chad416/hydraulic-cylinder-design-verification/reports/LD-80.md

# Calculation report LD-80: Loader-arm double-acting cylinder, pinned both ends, long stroke

Generated by `python -m cylver report`. Every number below is computed from `data/orders/LD-80.json` and `data/materials.json`. Sources and their check status: DOSSIER.md section 13.

## Revision history

| variant | tube OD | rod | buckling | fatigue (gov) | cushion peak bar | not met | open |
|---|---|---|---|---|---|---|---|
| rev A | 90.0 | 50 | 0.96 | 0.35 port A cross-bore | 463 | R-07, R-08, R-10 | R-15 |
| rev B | 90.0 | 63 | 1.65 | 0.39 port A cross-bore | 411 | R-08, R-10, R-11 | R-15 |
| rev C | 90.0 | 63 | 1.65 | 1.10 tube-to-base weld | 273 | none | R-15 |

## Analyses per revision

### rev A

| item | value |
|---|---|
| bore / rod / stroke | 80 / 50 / 1200 mm |
| rated / relief / supply | 200 / 220 / 200 bar |
| tube (sized) | E355+SR, OD 90.0 mm, wall 5.00 mm |
| base (sized) | 15 mm |
| rod | 42CrMo4+QT, Re 650 MPa (ruling section 50 mm) |
| pin-to-pin closed / extended | 1455 / 2655 mm |
| ports | through the tube wall |
| girth weld from base face | 6 mm |
| retract command limit | 1 |
| seals rod / piston | PU_ucup / PU_compact |

**Requirements**

| ID | requirement | method | result | limit | status |
|---|---|---|---|---|---|
| R-01 | The cylinder shall extend at >= 285 mm/s against 60 kN with full valve command. | A (duty simulation); T (bench) | 297 mm/s | >= 285 mm/s | met |
| R-02 | Stress 'tube bore von Mises, relief pressure' shall not exceed 225 MPa (Pm). | A | 182 MPa | <= 225 MPa | met |
| R-03 | Stress 'tube bore von Mises, proof pressure' shall not exceed 450 MPa (proof). | A | 272 MPa | <= 450 MPa | met |
| R-04 | Stress 'base plate centre (simply supported bound), relief' shall not exceed 338 MPa (Pb). | A | 194 MPa | <= 338 MPa | met |
| R-05 | Stress 'tube wall at the base junction, membrane + edge bending, 0 -> relief' shall not exceed 900 MPa (PL+Pb+Q). | A | 371 MPa | <= 900 MPa | met |
| R-06 | Stress 'rod thread at piston, pull at relief (no preload credit)' shall not exceed 325 MPa (Pm). | A | 74 MPa | <= 325 MPa | met |
| R-07 | The fully extended cylinder shall reach first yield (with clearance tilt, bows, 1 mm pin eccentricity and self weight) only above 1.5 x the push at relief pressure. | A | 0.96 x (106 kN) | >= 1.50 | NOT MET (elastic P_cr 141 kN; rod-only Euler 90 kN) |
| R-08 | Every fatigue-critical location shall survive 5.76e+05 design duty cycles with the partial factors applied (stress factor >= 1). | A; T (ISO 10771-1 Annex B type test) | port A cross-bore: 0.35 | >= 1.00 | NOT MET |
| R-09 | The radial extrusion gap of the piston seal at relief pressure shall not exceed the seal's allowable gap. | A; I (clearances) | 0.132 mm | <= 0.28 mm | met |
| R-10 | The cushion chamber pressure shall not exceed the proof pressure (330 bar) in any end-of-stroke case, 0-40 C oil. | A; T (cushion test) | 463 bar (A end, 0 C) | <= 330 bar | NOT MET |
| R-11 | The piston shall reach the end stop at <= 0.10 m/s. | A; T | 0.068 m/s | <= 0.10 m/s | met |
| R-12 | Motion shall be free of stick-slip down to 10 mm/s. | A; T (ISO 10100 module F) | onset 2.3 mm/s | <= 10 mm/s | met |
| R-13 | Load-holding drift shall be <= 5 mm in 10 min. | A; T (ISO 10100 module P) | thermal 4.2 mm for 5 K cooling | <= 5 mm | met (the requirement holds only while the locked oil cools < 5.9 K in 10 min; the order must state the thermal condition) |
| R-14 | The lowest hydraulic natural frequency over the stroke shall be reported to the machine builder (TPM). | A | 12.3 Hz | report | met |
| R-15 | Where the order names an ISO mounting, the mounting interface dimensions shall comply with ISO 6022 (25 MPa series). | I (dimensional inspection) | pin-to-pin dimensions from the order file | standard's tables | open (the dimension tables are in the paid standard and were not available; the example orders give their own pin dimensions) |

**Static stresses**

| check | category | MPa | allow MPa | util | basis |
|---|---|---|---|---|---|
| tube bore von Mises, relief pressure | Pm | 182 | 225 | 0.81 | Lame closed end; Re/2 |
| tube bore von Mises, proof pressure | proof | 272 | 450 | 0.61 | Lame closed end; no yield at proof |
| base plate centre (simply supported bound), relief | Pb | 194 | 338 | 0.57 | simply supported plate; 1.5 Re/sf |
| base plate edge (clamped bound), relief | Pb | 117 | 338 | 0.35 | clamped plate; the real base lies between the bounds |
| tube wall at the base junction, membrane + edge bending, 0 -> relief | PL+Pb+Q | 371 | 900 | 0.41 | shell edge solution, rm/t = 8.5; shakedown 2 Re |
| rod axial stress, push at relief | Pm | 56 | 325 | 0.17 | F/A (column stability in buckling) |
| rod thread at piston, pull at relief (no preload credit) | Pm | 74 | 325 | 0.23 | F/As, ISO 898-1 stress area |

**Buckling (fully extended)**

| item | value |
|---|---|
| pin-to-pin length | 2655 mm |
| guide length (piston to gland bearing) | 55 mm, clearance tilt 3.18 mrad |
| push at relief pressure | 111 kN |
| Euler, rod only over pin-to-pin length | 90 kN |
| elastic critical load, stepped FE | 141 kN (1.28 x push) |
| usable load (first yield with imperfections) | 106 kN (0.96 x push) |
| max deflection at push | 17.3 mm |
| reliability index (Re CoV 7 %, load CoV 10 %) | beta -0.36, Pf 6.4e-01 |

**Fatigue (duty-cycle simulation -> rainflow -> Miner)**

| location | basis | max stress MPa | damage / duty | life (duty cycles) | required | stress factor |
|---|---|---|---|---|---|---|
| tube-to-base weld | structural stress at 6 mm from the base by axisymmetric FE (6.46 x p; rigid-base shell solution 6.54 x p), EN 1993-1-9 cat 71 | 202 | 1.74e-05 | 57310 | 5.76e+05 | 0.46 |
| port A cross-bore | port through the tube wall, Kt 3 | 799 | 4.00 | < 1 (static) | 5.76e+05 | 0.35 |
| port B cross-bore | port through the tube wall, Kt 3 | 512 | 0.50 | 2 | 5.76e+05 | 0.55 |
| rod thread at piston nut | phi_n 0.3 x pull / As, M36x2, VDI 2230 endurance 42 MPa | 20 | 0.00 | inf | 5.76e+05 | 6.98 |

The governing location (port A cross-bore) exceeds static strength at the duty peak with the elastic Kt (in reality it yields locally). A life estimate and an equal-damage test pressure mean nothing until the design changes.

**Cushioning**

| end | oil C | entry m/s | energy kJ | peak bar | impact m/s |
|---|---|---|---|---|---|
| B (rod end, extending) | 40 | 0.297 | 0.07 | 126 | 0.068 |
| B (rod end, extending) | 0 | 0.297 | 0.07 | 127 | 0.059 |
| A (cap end, retracting) | 40 | 0.514 | 0.20 | 313 | 0.057 |
| A (cap end, retracting) | 0 | 0.514 | 0.20 | 463 | 0.050 |

Without cushions the cap-end impact speed would be 0.517 m/s.

**Friction, smoothness, drift, natural frequency**

| item | value |
|---|---|
| holding pressure (load / A_A) | 119 bar |
| breakaway friction at holding pressure (model) | 381 N |
| stick-slip onset, linear criterion dF/dv < 0 | 2.3 mm/s |
| stick-slip simulation | 1.2 mm/s: stick-slip, 4.6 mm/s: smooth, 10.0 mm/s: smooth |
| thermal drift, locked cap chamber, 5 K cooling | 4.2 mm (requirement holds only for < 5.9 K) |
| piston seal leakage budget left | 0.39 ml/min |
| hydraulic natural frequency at mid stroke: formula / model eigenvalue | 13.09 / 13.09 Hz |
| damping ratio at null (critical-centre valve, no leakage) | 0.0052 |
| position-loop velocity gain limit: model / Merritt 2 zeta omega | 5.47 / 0.85 1/s |

**FMEA** (occurrence from the computed margin, rule in fmea.py)

| failure mode | cause | effect | S | margin | O | D | RPN | verification |
|---|---|---|---|---|---|---|---|---|
| tube-to-base weld fatigue crack | pressure cycles x edge bending at the weld root; root defect | external leak, possible base separation | 10 | 0.46 (fatigue stress factor) | 9 | 7 | 630 | Q-1 type test; weld root NDT |
| rod / column buckling | push above usable load at full extension; worn bearings increase the tilt | bent rod, uncontrolled load drop | 10 | 0.96 (usable load / push at relief) | 9 | 6 | 540 | analysis only (R-07); clearance inspection I-1 |
| port cross-bore fatigue crack | pressure cycles x hole stress concentration | external leak at the port | 7 | 0.35 (fatigue stress factor) | 9 | 7 | 441 | Q-1 type test |
| cushion over-pressure | trapped cushion oil is not protected by the port relief; cold oil | seal extrusion, fatigue damage, tube yield | 8 | 0.71 (proof pressure / cushion peak) | 9 | 4 | 288 | C-1 cushion test with chamber transducer |
| drift under load | piston seal leakage; oil cooling in the locked chamber | load creeps down | 7 | 1.18 (drift allowance / thermal drift) | 7 | 5 | 245 | P-1 leakage test (thermal part only by analysis) |
| rod thread / piston nut fatigue | pull cycles; preload loss raises the alternating share (phi_n -> 1) | piston separates from rod, loss of load | 10 | 6.98 (fatigue stress factor (with preload)) | 2 | 8 | 160 | torque check at assembly; Q-1 |
| piston seal extrusion | extrusion gap grows with clearance wear and bore dilation | internal leak, drift, seal debris | 6 | 2.12 (allowable gap / gap at relief) | 2 | 5 | 60 | I-1 clearances; P-1 leakage |
| aerated oil / spongy motion | air entrainment, poor bleeding | low natural frequency, overshoot, cavitation erosion | 5 | 2.00 (not quantified as a margin (natural frequency reported as TPM)) | 2 | 5 | 50 | commissioning bleed procedure |
| stick-slip / jerky motion | static/Coulomb friction ratio too high; seal swell; low speed | poor positioning, noise, wear | 5 | 4.31 (smooth-speed requirement / stick-slip onset) | 2 | 4 | 40 | F-1/F-2 friction test |

**Acceptance test procedure (limits derived from this analysis)**

| step | module | test | pass limit | why |
|---|---|---|---|---|
| I-1 | inspection | piston guide and gland bearing diametral clearance | <= 0.20 / 0.15 mm | sets the buckling tilt (R-07) and the extrusion gap (R-09) |
| L-1 | ISO 10100 sec. 8.2 | leakage at low test pressure, sight test | no external leakage (test pressure per ISO 10100) | standard module |
| L-2 | ISO 10100 sec. 8.3 | proof / external leakage test | no external leakage, no permanent set; analysis at 330 bar gives 272 MPa < Re 450 MPa | R-03; the proof pressure value must be taken from ISO 10100 (here 1.5 x max(rated, relief) is assumed) |
| P-1 | ISO 10100 sec. 9 | piston seal leakage at rated pressure, cap side | <= 0.39 ml/min | the share of the R-13 drift budget left after thermal contraction |
| F-1 | ISO 10100 sec. 10.6.2 | static (breakaway) friction, unloaded | <= 260 N (1.3 x model) | the friction the speed and smoothness analyses assumed (R-01, R-12) |
| F-2 | ISO 10100 sec. 10.4.2 | friction at constant speed, both directions, 0.1-100 mm/s; fit the Stribeck model | stick-slip onset of the fitted curve <= 10 mm/s (model: 2.3 mm/s) | R-12; and it validates the seal model. An unloaded rig sees only the low-pressure static excess: run it with back pressure at the holding pressure if the rig allows |
| C-1 | project test (not in ISO 10100) | run into both ends at full speed, 0 C and 40 C oil; record the cushion chamber pressure | peak <= 330 bar; impact <= 0.10 m/s | R-10, R-11 (needs a transducer in the cushion chamber, not at the port) |
| Q-1 | ISO 10771-1 Annex B (type test, once per design) | cyclic pressure test 0 -> p_test, 1e6 cycles | n/a: the governing location exceeds static strength at the duty peak (redesign first) | same Miner damage at port A cross-bore as the design life (R-08) |

Bench evaluation demo on SYNTHETIC data (calibrated model + 1 % + 5 N noise; not a real test): fitted Coulomb 181 N, static excess 18 N, Stribeck speed 0.89 mm/s. F-1 PASS (194 <= 260 N); F-2 PASS (2 <= 10 N).

Buckling

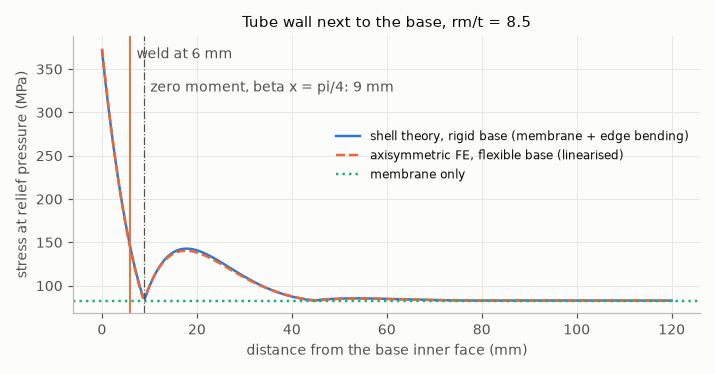
[picture p15: docs/img/LD-80_revA_junction.png]
Base junction


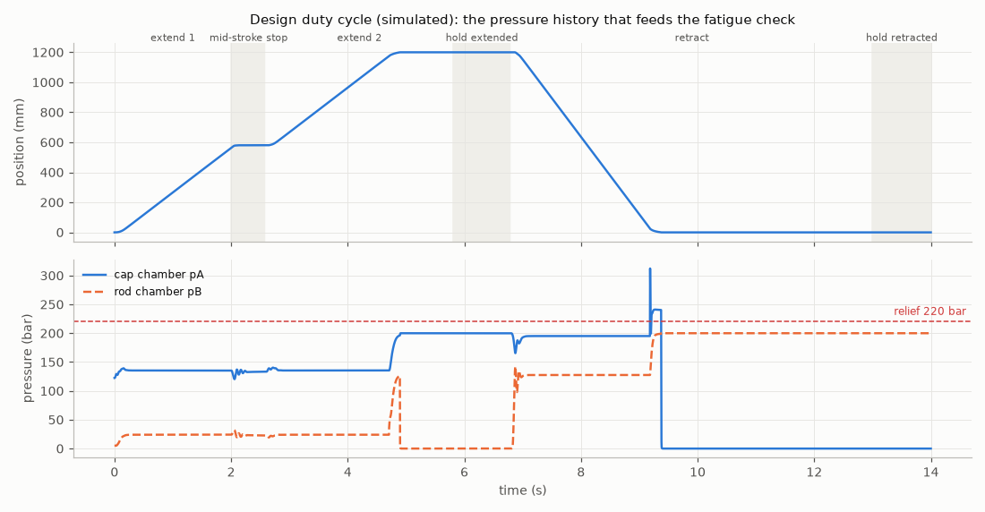
[picture p16: docs/img/LD-80_revA_duty.png]
Duty cycle


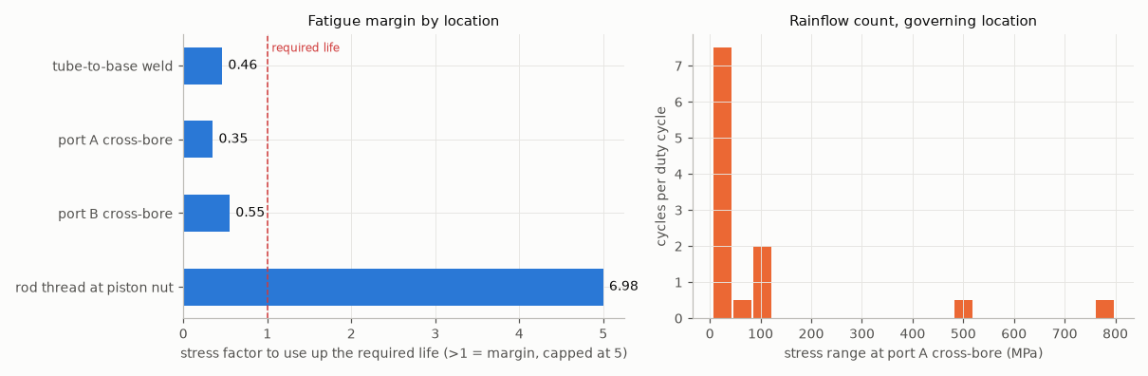
[picture p17: docs/img/LD-80_revA_fatigue.png]
Fatigue


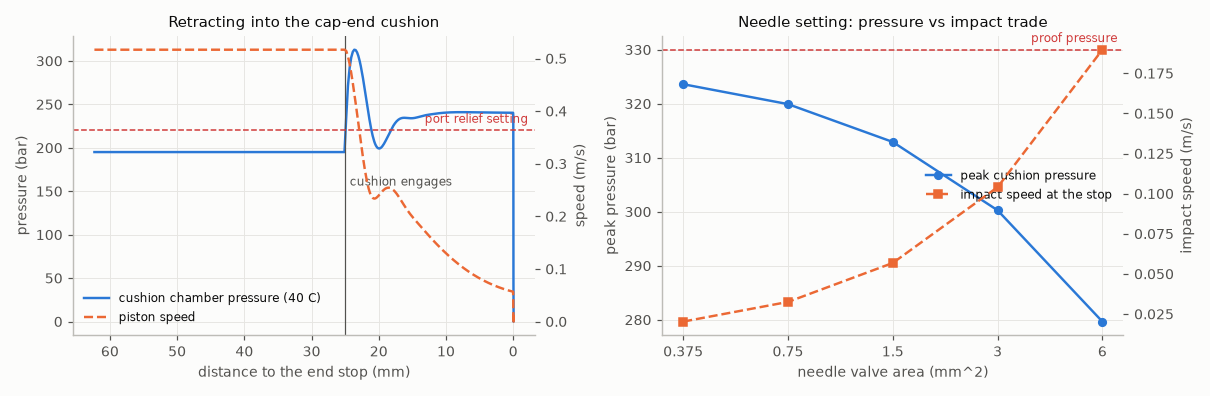
[picture p18: docs/img/LD-80_revA_cushion.png]
Cushion


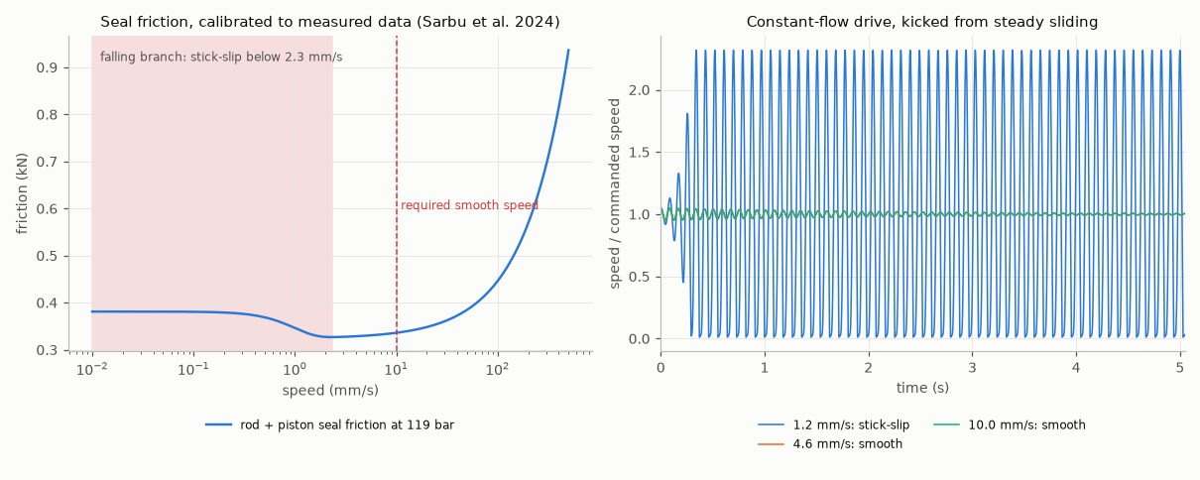
[picture p19: docs/img/LD-80_revA_friction.png]
Friction and stick-slip


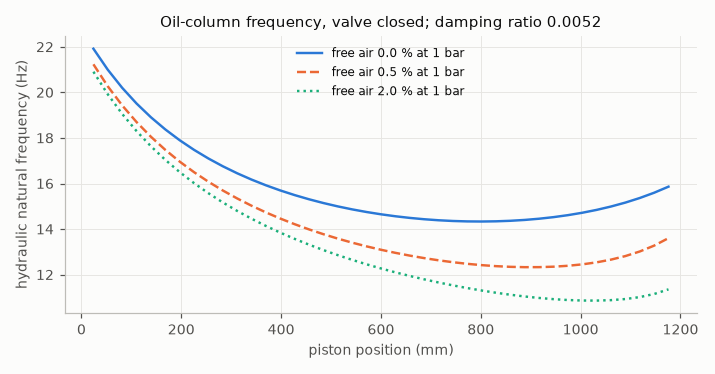
[picture p20: docs/img/LD-80_revA_frequency.png]
Natural frequency


### rev B

Why this revision: rev A fails the buckling requirement (usable load 0.96 x relief push). A 56 mm rod reaches only 1.33 at any stop-tube length; 63 mm with a 50 mm stop tube reaches the 1.5 target.

| item | value |
|---|---|
| bore / rod / stroke | 80 / 63 / 1200 mm |
| rated / relief / supply | 200 / 220 / 200 bar |
| tube (sized) | E355+SR, OD 90.0 mm, wall 5.00 mm |
| base (sized) | 15 mm |
| rod | 42CrMo4+QT, Re 650 MPa (ruling section 63 mm) |
| pin-to-pin closed / extended | 1505 / 2705 mm |
| ports | through the tube wall |
| girth weld from base face | 6 mm |
| retract command limit | 1 |
| seals rod / piston | PU_ucup / PU_compact |

**Requirements**

| ID | requirement | method | result | limit | status |
|---|---|---|---|---|---|
| R-01 | The cylinder shall extend at >= 285 mm/s against 60 kN with full valve command. | A (duty simulation); T (bench) | 298 mm/s | >= 285 mm/s | met |
| R-02 | Stress 'tube bore von Mises, relief pressure' shall not exceed 225 MPa (Pm). | A | 182 MPa | <= 225 MPa | met |
| R-03 | Stress 'tube bore von Mises, proof pressure' shall not exceed 450 MPa (proof). | A | 272 MPa | <= 450 MPa | met |
| R-04 | Stress 'base plate centre (simply supported bound), relief' shall not exceed 338 MPa (Pb). | A | 194 MPa | <= 338 MPa | met |
| R-05 | Stress 'tube wall at the base junction, membrane + edge bending, 0 -> relief' shall not exceed 900 MPa (PL+Pb+Q). | A | 371 MPa | <= 900 MPa | met |
| R-06 | Stress 'rod thread at piston, pull at relief (no preload credit)' shall not exceed 325 MPa (Pm). | A | 25 MPa | <= 325 MPa | met |
| R-07 | The fully extended cylinder shall reach first yield (with clearance tilt, bows, 1 mm pin eccentricity and self weight) only above 1.5 x the push at relief pressure. | A | 1.65 x (183 kN) | >= 1.50 | met (elastic P_cr 280 kN; rod-only Euler 219 kN) |
| R-08 | Every fatigue-critical location shall survive 5.76e+05 design duty cycles with the partial factors applied (stress factor >= 1). | A; T (ISO 10771-1 Annex B type test) | port A cross-bore: 0.39 | >= 1.00 | NOT MET |
| R-09 | The radial extrusion gap of the piston seal at relief pressure shall not exceed the seal's allowable gap. | A; I (clearances) | 0.132 mm | <= 0.28 mm | met |
| R-10 | The cushion chamber pressure shall not exceed the proof pressure (330 bar) in any end-of-stroke case, 0-40 C oil. | A; T (cushion test) | 411 bar (A end, 0 C) | <= 330 bar | NOT MET |
| R-11 | The piston shall reach the end stop at <= 0.10 m/s. | A; T | 0.127 m/s | <= 0.10 m/s | NOT MET |
| R-12 | Motion shall be free of stick-slip down to 10 mm/s. | A; T (ISO 10100 module F) | onset 2.3 mm/s | <= 10 mm/s | met |
| R-13 | Load-holding drift shall be <= 5 mm in 10 min. | A; T (ISO 10100 module P) | thermal 4.2 mm for 5 K cooling | <= 5 mm | met (the requirement holds only while the locked oil cools < 5.9 K in 10 min; the order must state the thermal condition) |
| R-14 | The lowest hydraulic natural frequency over the stroke shall be reported to the machine builder (TPM). | A | 11.1 Hz | report | met |
| R-15 | Where the order names an ISO mounting, the mounting interface dimensions shall comply with ISO 6022 (25 MPa series). | I (dimensional inspection) | pin-to-pin dimensions from the order file | standard's tables | open (the dimension tables are in the paid standard and were not available; the example orders give their own pin dimensions) |

**Static stresses**

| check | category | MPa | allow MPa | util | basis |
|---|---|---|---|---|---|
| tube bore von Mises, relief pressure | Pm | 182 | 225 | 0.81 | Lame closed end; Re/2 |
| tube bore von Mises, proof pressure | proof | 272 | 450 | 0.61 | Lame closed end; no yield at proof |
| base plate centre (simply supported bound), relief | Pb | 194 | 338 | 0.57 | simply supported plate; 1.5 Re/sf |
| base plate edge (clamped bound), relief | Pb | 117 | 338 | 0.35 | clamped plate; the real base lies between the bounds |
| tube wall at the base junction, membrane + edge bending, 0 -> relief | PL+Pb+Q | 371 | 900 | 0.41 | shell edge solution, rm/t = 8.5; shakedown 2 Re |
| rod axial stress, push at relief | Pm | 35 | 325 | 0.11 | F/A (column stability in buckling) |
| rod thread at piston, pull at relief (no preload credit) | Pm | 25 | 325 | 0.08 | F/As, ISO 898-1 stress area |

**Buckling (fully extended)**

| item | value |
|---|---|
| pin-to-pin length | 2705 mm |
| guide length (piston to gland bearing) | 105 mm, clearance tilt 1.67 mrad |
| push at relief pressure | 111 kN |
| Euler, rod only over pin-to-pin length | 219 kN |
| elastic critical load, stepped FE | 280 kN (2.53 x push) |
| usable load (first yield with imperfections) | 183 kN (1.65 x push) |
| max deflection at push | 3.9 mm |
| reliability index (Re CoV 7 %, load CoV 10 %) | beta 4.28, Pf 9.4e-06 |

**Fatigue (duty-cycle simulation -> rainflow -> Miner)**

| location | basis | max stress MPa | damage / duty | life (duty cycles) | required | stress factor |
|---|---|---|---|---|---|---|
| tube-to-base weld | structural stress at 6 mm from the base by axisymmetric FE (6.46 x p; rigid-base shell solution 6.54 x p), EN 1993-1-9 cat 71 | 181 | 1.28e-05 | 78267 | 5.76e+05 | 0.52 |
| port A cross-bore | port through the tube wall, Kt 3 | 718 | 6.00 | < 1 (static) | 5.76e+05 | 0.39 |
| port B cross-bore | port through the tube wall, Kt 3 | 512 | 5.50 | < 1 (static) | 5.76e+05 | 0.55 |
| rod thread at piston nut | phi_n 0.3 x pull / As, M48x2, VDI 2230 endurance 41 MPa | 7 | 0.00 | inf | 5.76e+05 | 18.53 |

The governing location (port A cross-bore) exceeds static strength at the duty peak with the elastic Kt (in reality it yields locally). A life estimate and an equal-damage test pressure mean nothing until the design changes.

**Cushioning**

| end | oil C | entry m/s | energy kJ | peak bar | impact m/s |
|---|---|---|---|---|---|
| B (rod end, extending) | 40 | 0.298 | 0.07 | 154 | 0.127 |
| B (rod end, extending) | 0 | 0.298 | 0.07 | 180 | 0.114 |
| A (cap end, retracting) | 40 | 0.462 | 0.16 | 281 | 0.050 |
| A (cap end, retracting) | 0 | 0.462 | 0.16 | 411 | 0.044 |

Without cushions the cap-end impact speed would be 0.465 m/s.

**Friction, smoothness, drift, natural frequency**

| item | value |
|---|---|
| holding pressure (load / A_A) | 119 bar |
| breakaway friction at holding pressure (model) | 401 N |
| stick-slip onset, linear criterion dF/dv < 0 | 2.3 mm/s |
| stick-slip simulation | 1.2 mm/s: stick-slip, 4.6 mm/s: smooth, 10.0 mm/s: smooth |
| thermal drift, locked cap chamber, 5 K cooling | 4.2 mm (requirement holds only for < 5.9 K) |
| piston seal leakage budget left | 0.39 ml/min |
| hydraulic natural frequency at mid stroke: formula / model eigenvalue | 12.55 / 12.54 Hz |
| damping ratio at null (critical-centre valve, no leakage) | 0.0059 |
| position-loop velocity gain limit: model / Merritt 2 zeta omega | 5.25 / 0.93 1/s |

**FMEA** (occurrence from the computed margin, rule in fmea.py)

| failure mode | cause | effect | S | margin | O | D | RPN | verification |
|---|---|---|---|---|---|---|---|---|
| tube-to-base weld fatigue crack | pressure cycles x edge bending at the weld root; root defect | external leak, possible base separation | 10 | 0.52 (fatigue stress factor) | 9 | 7 | 630 | Q-1 type test; weld root NDT |
| port cross-bore fatigue crack | pressure cycles x hole stress concentration | external leak at the port | 7 | 0.39 (fatigue stress factor) | 9 | 7 | 441 | Q-1 type test |
| cushion over-pressure | trapped cushion oil is not protected by the port relief; cold oil | seal extrusion, fatigue damage, tube yield | 8 | 0.80 (proof pressure / cushion peak) | 9 | 4 | 288 | C-1 cushion test with chamber transducer |
| drift under load | piston seal leakage; oil cooling in the locked chamber | load creeps down | 7 | 1.18 (drift allowance / thermal drift) | 7 | 5 | 245 | P-1 leakage test (thermal part only by analysis) |
| rod / column buckling | push above usable load at full extension; worn bearings increase the tilt | bent rod, uncontrolled load drop | 10 | 1.65 (usable load / push at relief) | 3 | 6 | 180 | analysis only (R-07); clearance inspection I-1 |
| rod thread / piston nut fatigue | pull cycles; preload loss raises the alternating share (phi_n -> 1) | piston separates from rod, loss of load | 10 | 18.53 (fatigue stress factor (with preload)) | 2 | 8 | 160 | torque check at assembly; Q-1 |
| piston seal extrusion | extrusion gap grows with clearance wear and bore dilation | internal leak, drift, seal debris | 6 | 2.12 (allowable gap / gap at relief) | 2 | 5 | 60 | I-1 clearances; P-1 leakage |
| aerated oil / spongy motion | air entrainment, poor bleeding | low natural frequency, overshoot, cavitation erosion | 5 | 2.00 (not quantified as a margin (natural frequency reported as TPM)) | 2 | 5 | 50 | commissioning bleed procedure |
| stick-slip / jerky motion | static/Coulomb friction ratio too high; seal swell; low speed | poor positioning, noise, wear | 5 | 4.34 (smooth-speed requirement / stick-slip onset) | 2 | 4 | 40 | F-1/F-2 friction test |

**Acceptance test procedure (limits derived from this analysis)**

| step | module | test | pass limit | why |
|---|---|---|---|---|
| I-1 | inspection | piston guide and gland bearing diametral clearance | <= 0.20 / 0.15 mm | sets the buckling tilt (R-07) and the extrusion gap (R-09) |
| L-1 | ISO 10100 sec. 8.2 | leakage at low test pressure, sight test | no external leakage (test pressure per ISO 10100) | standard module |
| L-2 | ISO 10100 sec. 8.3 | proof / external leakage test | no external leakage, no permanent set; analysis at 330 bar gives 272 MPa < Re 450 MPa | R-03; the proof pressure value must be taken from ISO 10100 (here 1.5 x max(rated, relief) is assumed) |
| P-1 | ISO 10100 sec. 9 | piston seal leakage at rated pressure, cap side | <= 0.39 ml/min | the share of the R-13 drift budget left after thermal contraction |
| F-1 | ISO 10100 sec. 10.6.2 | static (breakaway) friction, unloaded | <= 286 N (1.3 x model) | the friction the speed and smoothness analyses assumed (R-01, R-12) |
| F-2 | ISO 10100 sec. 10.4.2 | friction at constant speed, both directions, 0.1-100 mm/s; fit the Stribeck model | stick-slip onset of the fitted curve <= 10 mm/s (model: 2.3 mm/s) | R-12; and it validates the seal model. An unloaded rig sees only the low-pressure static excess: run it with back pressure at the holding pressure if the rig allows |
| C-1 | project test (not in ISO 10100) | run into both ends at full speed, 0 C and 40 C oil; record the cushion chamber pressure | peak <= 330 bar; impact <= 0.10 m/s | R-10, R-11 (needs a transducer in the cushion chamber, not at the port) |
| Q-1 | ISO 10771-1 Annex B (type test, once per design) | cyclic pressure test 0 -> p_test, 1e6 cycles | n/a: the governing location exceeds static strength at the duty peak (redesign first) | same Miner damage at port A cross-bore as the design life (R-08) |

Bench evaluation demo on SYNTHETIC data (calibrated model + 1 % + 5 N noise; not a real test): fitted Coulomb 200 N, static excess 20 N, Stribeck speed 0.89 mm/s. F-1 PASS (214 <= 286 N); F-2 PASS (2 <= 10 N).

### rev C

Why this revision: rev B fixes buckling, but the base weld fails fatigue (ports through the tube wall govern at 0.39) and the overrunning retraction (0.49 m/s) drives the cap cushion to 411 bar; the rod-end cushion lets the piston hit the stop at 0.19 m/s; and the model criteria of the seal trade favour the PTFE system (lower friction, measured-data stick-slip onset 1.8 vs 2.3 mm/s, larger extrusion margin against the seal maker's tables); see decision D-15 for the judgement criteria. Changes: ports into the end blocks, weld at the zero-moment point (9 mm), retract command limited to 0.6, cap needle 3 mm2 and a separate rod-end needle 0.6 mm2, PTFE seal system.

| item | value |
|---|---|
| bore / rod / stroke | 80 / 63 / 1200 mm |
| rated / relief / supply | 200 / 220 / 200 bar |
| tube (sized) | E355+SR, OD 90.0 mm, wall 5.00 mm |
| base (sized) | 15 mm |
| rod | 42CrMo4+QT, Re 650 MPa (ruling section 63 mm) |
| pin-to-pin closed / extended | 1505 / 2705 mm |
| ports | in the base and head blocks |
| girth weld from base face | 9 mm |
| retract command limit | 0.6 |
| seals rod / piston | PTFE_step+PU / PTFE_compact |

**Requirements**

| ID | requirement | method | result | limit | status |
|---|---|---|---|---|---|
| R-01 | The cylinder shall extend at >= 285 mm/s against 60 kN with full valve command. | A (duty simulation); T (bench) | 298 mm/s | >= 285 mm/s | met |
| R-02 | Stress 'tube bore von Mises, relief pressure' shall not exceed 225 MPa (Pm). | A | 182 MPa | <= 225 MPa | met |
| R-03 | Stress 'tube bore von Mises, proof pressure' shall not exceed 450 MPa (proof). | A | 272 MPa | <= 450 MPa | met |
| R-04 | Stress 'base plate centre (simply supported bound), relief' shall not exceed 338 MPa (Pb). | A | 194 MPa | <= 338 MPa | met |
| R-05 | Stress 'tube wall at the base junction, membrane + edge bending, 0 -> relief' shall not exceed 900 MPa (PL+Pb+Q). | A | 371 MPa | <= 900 MPa | met |
| R-06 | Stress 'rod thread at piston, pull at relief (no preload credit)' shall not exceed 325 MPa (Pm). | A | 25 MPa | <= 325 MPa | met |
| R-07 | The fully extended cylinder shall reach first yield (with clearance tilt, bows, 1 mm pin eccentricity and self weight) only above 1.5 x the push at relief pressure. | A | 1.65 x (183 kN) | >= 1.50 | met (elastic P_cr 280 kN; rod-only Euler 219 kN) |
| R-08 | Every fatigue-critical location shall survive 5.76e+05 design duty cycles with the partial factors applied (stress factor >= 1). | A; T (ISO 10771-1 Annex B type test) | tube-to-base weld: 1.10 | >= 1.00 | met |
| R-09 | The radial extrusion gap of the piston seal at relief pressure shall not exceed the seal's allowable gap. | A; I (clearances) | 0.132 mm | <= 0.29 mm | met |
| R-10 | The cushion chamber pressure shall not exceed the proof pressure (330 bar) in any end-of-stroke case, 0-40 C oil. | A; T (cushion test) | 273 bar (A end, 0 C) | <= 330 bar | met |
| R-11 | The piston shall reach the end stop at <= 0.10 m/s. | A; T | 0.090 m/s | <= 0.10 m/s | met |
| R-12 | Motion shall be free of stick-slip down to 10 mm/s. | A; T (ISO 10100 module F) | onset 1.8 mm/s | <= 10 mm/s | met |
| R-13 | Load-holding drift shall be <= 5 mm in 10 min. | A; T (ISO 10100 module P) | thermal 4.2 mm for 5 K cooling | <= 5 mm | met (the requirement holds only while the locked oil cools < 5.9 K in 10 min; the order must state the thermal condition) |
| R-14 | The lowest hydraulic natural frequency over the stroke shall be reported to the machine builder (TPM). | A | 11.1 Hz | report | met |
| R-15 | Where the order names an ISO mounting, the mounting interface dimensions shall comply with ISO 6022 (25 MPa series). | I (dimensional inspection) | pin-to-pin dimensions from the order file | standard's tables | open (the dimension tables are in the paid standard and were not available; the example orders give their own pin dimensions) |

**Static stresses**

| check | category | MPa | allow MPa | util | basis |
|---|---|---|---|---|---|
| tube bore von Mises, relief pressure | Pm | 182 | 225 | 0.81 | Lame closed end; Re/2 |
| tube bore von Mises, proof pressure | proof | 272 | 450 | 0.61 | Lame closed end; no yield at proof |
| base plate centre (simply supported bound), relief | Pb | 194 | 338 | 0.57 | simply supported plate; 1.5 Re/sf |
| base plate edge (clamped bound), relief | Pb | 117 | 338 | 0.35 | clamped plate; the real base lies between the bounds |
| tube wall at the base junction, membrane + edge bending, 0 -> relief | PL+Pb+Q | 371 | 900 | 0.41 | shell edge solution, rm/t = 8.5; shakedown 2 Re |
| rod axial stress, push at relief | Pm | 35 | 325 | 0.11 | F/A (column stability in buckling) |
| rod thread at piston, pull at relief (no preload credit) | Pm | 25 | 325 | 0.08 | F/As, ISO 898-1 stress area |

**Buckling (fully extended)**

| item | value |
|---|---|
| pin-to-pin length | 2705 mm |
| guide length (piston to gland bearing) | 105 mm, clearance tilt 1.67 mrad |
| push at relief pressure | 111 kN |
| Euler, rod only over pin-to-pin length | 219 kN |
| elastic critical load, stepped FE | 280 kN (2.53 x push) |
| usable load (first yield with imperfections) | 183 kN (1.65 x push) |
| max deflection at push | 3.9 mm |
| reliability index (Re CoV 7 %, load CoV 10 %) | beta 4.28, Pf 9.4e-06 |

**Fatigue (duty-cycle simulation -> rainflow -> Miner)**

| location | basis | max stress MPa | damage / duty | life (duty cycles) | required | stress factor |
|---|---|---|---|---|---|---|
| tube-to-base weld | structural stress at 9 mm from the base by axisymmetric FE (4.01 x p; rigid-base shell solution 3.83 x p), EN 1993-1-9 cat 71 | 87 | 1.29e-06 | 7.72e+05 | 5.76e+05 | 1.10 |
| port A cross-bore | port in the end block, Kt 3 | 65 | 0.00 | inf | 5.76e+05 | 4.34 |
| port B cross-bore | port in the end block, Kt 3 | 60 | 0.00 | inf | 5.76e+05 | 4.21 |
| rod thread at piston nut | phi_n 0.3 x pull / As, M48x2, VDI 2230 endurance 41 MPa | 7 | 0.00 | inf | 5.76e+05 | 16.35 |

Equal-damage constant-amplitude test pressure for the governing location (tube-to-base weld): 150 bar for 1e6 cycles, 119 bar for 2e6 cycles.

**Cushioning**

| end | oil C | entry m/s | energy kJ | peak bar | impact m/s |
|---|---|---|---|---|---|
| B (rod end, extending) | 40 | 0.298 | 0.07 | 192 | 0.077 |
| B (rod end, extending) | 0 | 0.298 | 0.07 | 205 | 0.050 |
| A (cap end, retracting) | 40 | 0.280 | 0.06 | 217 | 0.090 |
| A (cap end, retracting) | 0 | 0.280 | 0.06 | 273 | 0.085 |

Without cushions the cap-end impact speed would be 0.281 m/s.

**Friction, smoothness, drift, natural frequency**

| item | value |
|---|---|
| holding pressure (load / A_A) | 119 bar |
| breakaway friction at holding pressure (model) | 288 N |
| stick-slip onset, linear criterion dF/dv < 0 | 1.8 mm/s |
| stick-slip simulation | 0.9 mm/s: stick-slip, 3.7 mm/s: smooth, 10.0 mm/s: smooth |
| thermal drift, locked cap chamber, 5 K cooling | 4.2 mm (requirement holds only for < 5.9 K) |
| piston seal leakage budget left | 0.39 ml/min |
| hydraulic natural frequency at mid stroke: formula / model eigenvalue | 12.55 / 12.54 Hz |
| damping ratio at null (critical-centre valve, no leakage) | 0.0050 |
| position-loop velocity gain limit: model / Merritt 2 zeta omega | 4.48 / 0.79 1/s |

**FMEA** (occurrence from the computed margin, rule in fmea.py)

| failure mode | cause | effect | S | margin | O | D | RPN | verification |
|---|---|---|---|---|---|---|---|---|
| tube-to-base weld fatigue crack | pressure cycles x edge bending at the weld root; root defect | external leak, possible base separation | 10 | 1.10 (fatigue stress factor) | 7 | 7 | 490 | Q-1 type test; weld root NDT |
| drift under load | piston seal leakage; oil cooling in the locked chamber | load creeps down | 7 | 1.18 (drift allowance / thermal drift) | 7 | 5 | 245 | P-1 leakage test (thermal part only by analysis) |
| rod / column buckling | push above usable load at full extension; worn bearings increase the tilt | bent rod, uncontrolled load drop | 10 | 1.65 (usable load / push at relief) | 3 | 6 | 180 | analysis only (R-07); clearance inspection I-1 |
| rod thread / piston nut fatigue | pull cycles; preload loss raises the alternating share (phi_n -> 1) | piston separates from rod, loss of load | 10 | 16.35 (fatigue stress factor (with preload)) | 2 | 8 | 160 | torque check at assembly; Q-1 |
| cushion over-pressure | trapped cushion oil is not protected by the port relief; cold oil | seal extrusion, fatigue damage, tube yield | 8 | 1.21 (proof pressure / cushion peak) | 5 | 4 | 160 | C-1 cushion test with chamber transducer |
| port cross-bore fatigue crack | pressure cycles x hole stress concentration | external leak at the port | 7 | 4.21 (fatigue stress factor) | 2 | 7 | 98 | Q-1 type test |
| piston seal extrusion | extrusion gap grows with clearance wear and bore dilation | internal leak, drift, seal debris | 6 | 2.19 (allowable gap / gap at relief) | 2 | 5 | 60 | I-1 clearances; P-1 leakage |
| aerated oil / spongy motion | air entrainment, poor bleeding | low natural frequency, overshoot, cavitation erosion | 5 | 2.00 (not quantified as a margin (natural frequency reported as TPM)) | 2 | 5 | 50 | commissioning bleed procedure |
| stick-slip / jerky motion | static/Coulomb friction ratio too high; seal swell; low speed | poor positioning, noise, wear | 5 | 5.44 (smooth-speed requirement / stick-slip onset) | 2 | 4 | 40 | F-1/F-2 friction test |

**Acceptance test procedure (limits derived from this analysis)**

| step | module | test | pass limit | why |
|---|---|---|---|---|
| I-1 | inspection | piston guide and gland bearing diametral clearance | <= 0.20 / 0.15 mm | sets the buckling tilt (R-07) and the extrusion gap (R-09) |
| L-1 | ISO 10100 sec. 8.2 | leakage at low test pressure, sight test | no external leakage (test pressure per ISO 10100) | standard module |
| L-2 | ISO 10100 sec. 8.3 | proof / external leakage test | no external leakage, no permanent set; analysis at 330 bar gives 272 MPa < Re 450 MPa | R-03; the proof pressure value must be taken from ISO 10100 (here 1.5 x max(rated, relief) is assumed) |
| P-1 | ISO 10100 sec. 9 | piston seal leakage at rated pressure, cap side | <= 0.39 ml/min | the share of the R-13 drift budget left after thermal contraction |
| F-1 | ISO 10100 sec. 10.6.2 | static (breakaway) friction, unloaded | <= 241 N (1.3 x model) | the friction the speed and smoothness analyses assumed (R-01, R-12) |
| F-2 | ISO 10100 sec. 10.4.2 | friction at constant speed, both directions, 0.1-100 mm/s; fit the Stribeck model | stick-slip onset of the fitted curve <= 10 mm/s (model: 1.8 mm/s) | R-12; and it validates the seal model. An unloaded rig sees only the low-pressure static excess: run it with back pressure at the holding pressure if the rig allows |
| C-1 | project test (not in ISO 10100) | run into both ends at full speed, 0 C and 40 C oil; record the cushion chamber pressure | peak <= 330 bar; impact <= 0.10 m/s | R-10, R-11 (needs a transducer in the cushion chamber, not at the port) |
| Q-1 | ISO 10771-1 Annex B (type test, once per design) | cyclic pressure test 0 -> p_test, 1e6 cycles | p_test >= 150 bar on the A side, no failure | same Miner damage at tube-to-base weld as the design life (R-08); equal-damage pressure for 2e6 cycles: 119 bar |

Bench evaluation demo on SYNTHETIC data (calibrated model + 1 % + 5 N noise; not a real test): fitted Coulomb 159 N, static excess 19 N, Stribeck speed 0.53 mm/s. F-1 PASS (181 <= 241 N); F-2 PASS (1 <= 10 N).

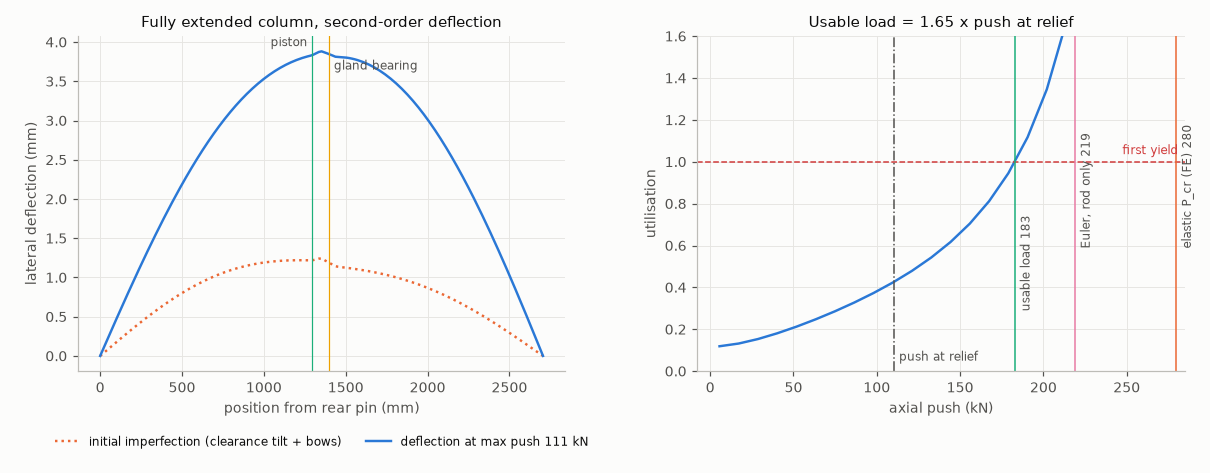
[picture p21: docs/img/LD-80_revC_buckling.png]
Buckling


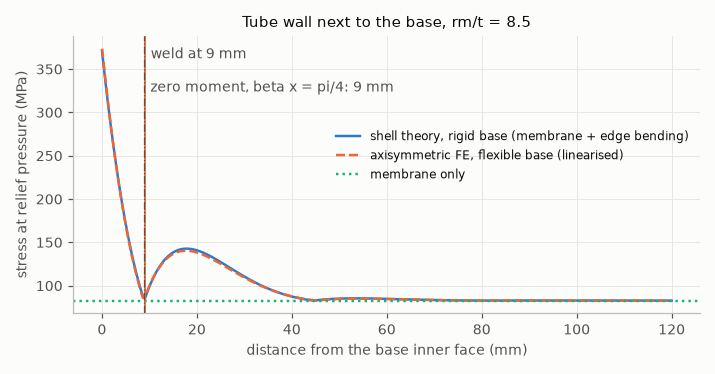
[picture p22: docs/img/LD-80_revC_junction.png]
Base junction


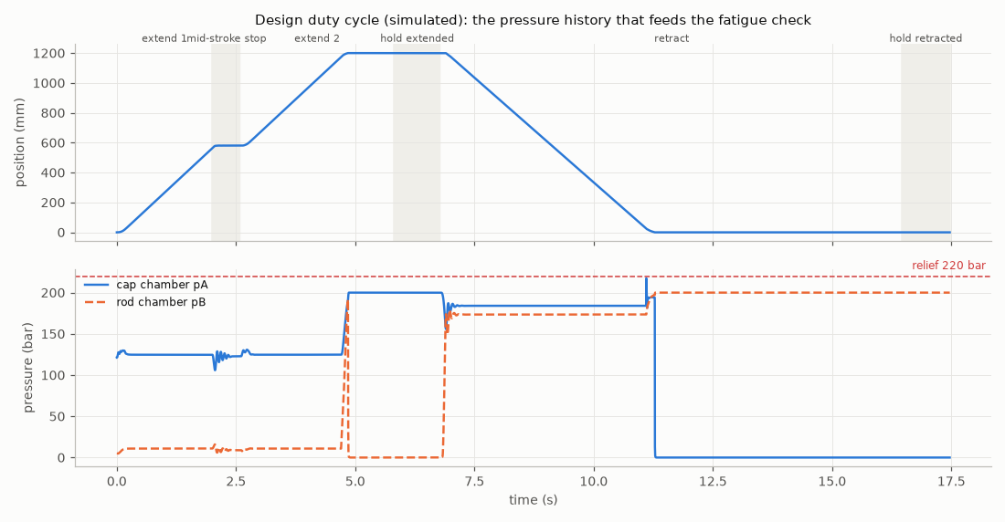
[picture p23: docs/img/LD-80_revC_duty.png]
Duty cycle


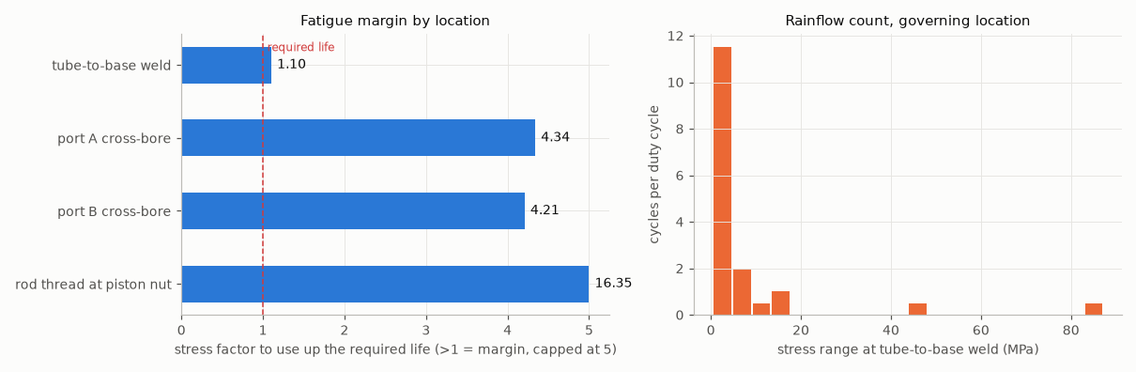
[picture p24: docs/img/LD-80_revC_fatigue.png]
Fatigue


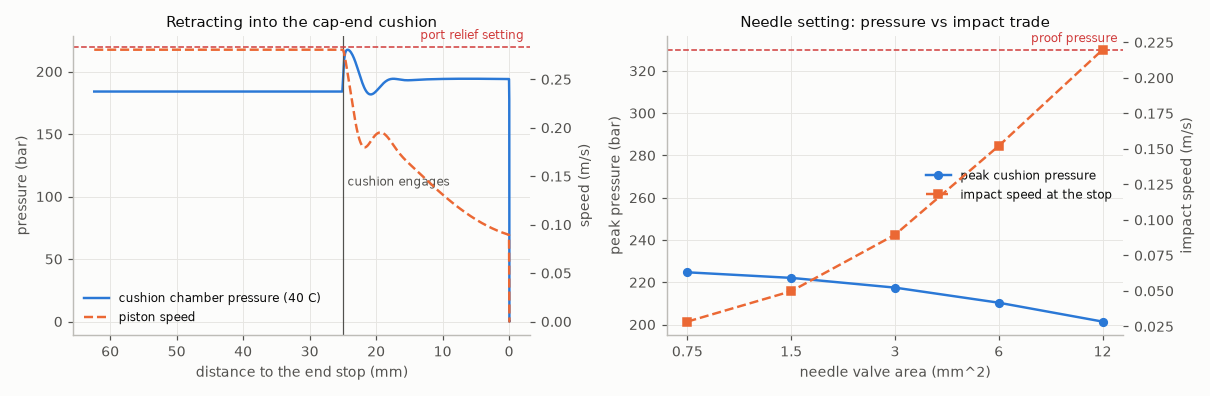
[picture p25: docs/img/LD-80_revC_cushion.png]
Cushion


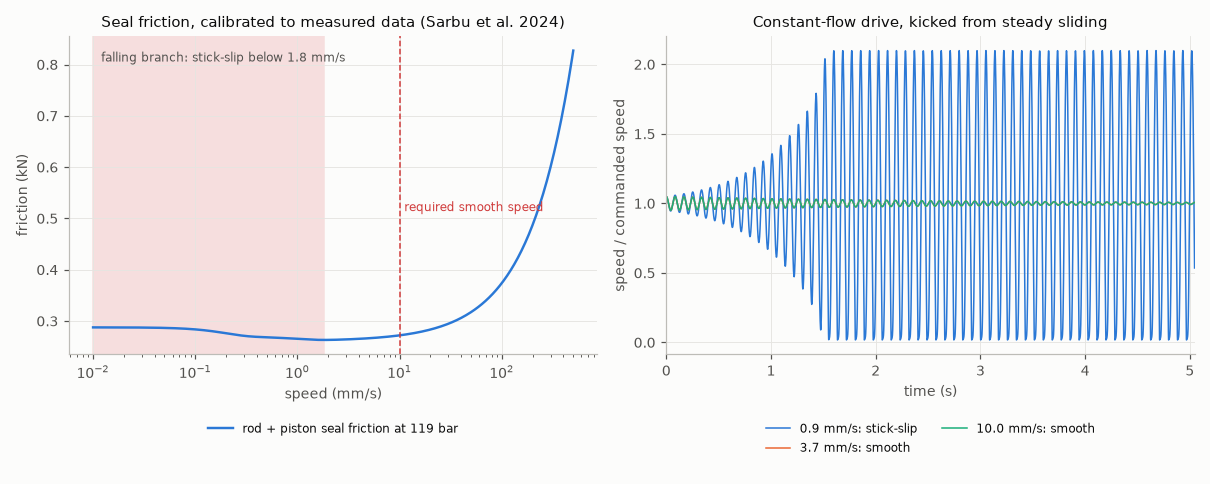
[picture p26: docs/img/LD-80_revC_friction.png]
Friction and stick-slip


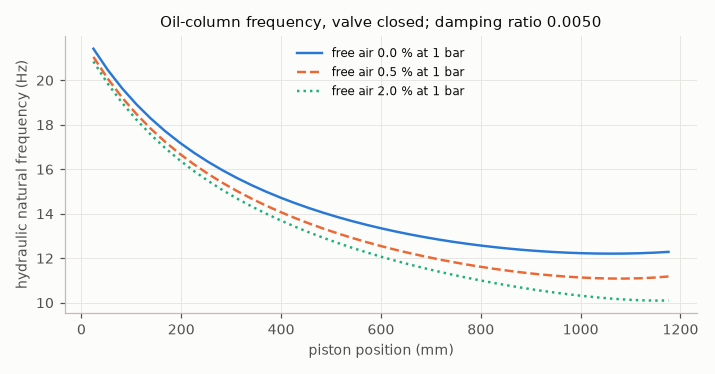
[picture p27: docs/img/LD-80_revC_frequency.png]
Natural frequency


## Trade studies (final revision rev C)

**Seal system** - rank: PU U-cup + PU compact > PTFE step seal + PU tandem, PTFE piston. Weight changes of +-10 % that flip the winner: none. Share of 2000 random weight sets won: PU U-cup + PU compact 100 %, PTFE step seal + PU tandem, PTFE piston 0 %.

| alternative | smooth motion (model) (25) | friction loss (model) (10) | extrusion margin (model) (20) | dry rod / static tightness (judgement) (20) | contamination tolerance (judgement) (15) | cost (judgement) (10) | total |
|---|---|---|---|---|---|---|---|
| PU U-cup + PU compact | 3.2 | 9.3 | 5.6 | 8.0 | 7.0 | 8.0 | 6.29 |
| PTFE step seal + PU tandem, PTFE piston | 3.7 | 9.7 | 6.0 | 7.0 | 6.0 | 5.0 | 5.88 |

Computed inputs: PU U-cup + PU compact: stick-slip onset mm/s 2.31, friction % of thrust 0.74, extrusion margin 2.12; PTFE step seal + PU tandem, PTFE piston: stick-slip onset mm/s 1.84, friction % of thrust 0.60, extrusion margin 2.19

Judgement rationale: *dry rod / static tightness*: PU lips seal well at low pressure; PTFE step seals rely on the secondary PU seal for a dry rod. *contamination tolerance*: PU is the more abrasion-tolerant lip material in dirty mobile service. *cost*: PTFE systems need more parts (energiser, back-up) and tighter groove tolerances.

**Rod surface** - rank: HVOF WC-CoCr thermal spray > laser cladding (Ni-base alloy) > nitrocarburise + post-oxidise > hard chrome (Cr VI electroplate). Weight changes of +-10 % that flip the winner: none. Share of 2000 random weight sets won: hard chrome (Cr VI electroplate) 6 %, HVOF WC-CoCr thermal spray 65 %, laser cladding (Ni-base alloy) 24 %, nitrocarburise + post-oxidise 6 %.

| alternative | corrosion resistance (25) | wear / impact resistance (20) | regulatory risk (20) | cost (15) | long-rod capability (10) | field repairability (10) | total |
|---|---|---|---|---|---|---|---|
| hard chrome (Cr VI electroplate) | 6.0 | 6.0 | 2.0 | 9.0 | 9.0 | 8.0 | 6.15 |
| HVOF WC-CoCr thermal spray | 7.0 | 9.0 | 9.0 | 4.0 | 6.0 | 5.0 | 7.05 |
| laser cladding (Ni-base alloy) | 9.0 | 7.0 | 9.0 | 3.0 | 6.0 | 4.0 | 6.90 |
| nitrocarburise + post-oxidise | 6.0 | 5.0 | 9.0 | 8.0 | 7.0 | 3.0 | 6.50 |

Judgement rationale: *regulatory risk*: Cr(VI) for hard chrome needs REACH authorisation today; ECHA submitted a restriction dossier on 11 Apr 2025, consultation ran to 18 Dec 2025, RAC/SEAC opinions pending in May 2026 (Freyr, 25 May 2026). Score 2 = real chance the process must change during the product life.. *corrosion / wear / cost / capability / repairability*: engineering judgement from published comparisons, NOT measured here; a neutral salt-spray (ISO 9227) and an abrasion test on coupons would replace these scores.

**Tube material** - rank: E355+SR > 25CrMo4+QT. Weight changes of +-10 % that flip the winner: none. Share of 2000 random weight sets won: E355+SR 100 %, 25CrMo4+QT 0 %.

| alternative | mass (model) (10) | weld fatigue (model) (25) | port fatigue (model) (15) | weldability (judgement) (20) | availability honed (judgement) (15) | cost (judgement) (15) | total |
|---|---|---|---|---|---|---|---|
| E355+SR | 9.9 | 4.0 | 10.0 | 9.0 | 9.0 | 8.0 | 7.85 |
| 25CrMo4+QT | 10.0 | 2.0 | 10.0 | 5.0 | 5.0 | 5.0 | 5.51 |

Computed inputs: E355+SR: wall mm 5.00, kg/m 10.48, port fatigue factor 4.21, weld fatigue factor 1.10; 25CrMo4+QT: wall mm 3.75, kg/m 7.75, port fatigue factor 5.81, weld fatigue factor 0.80

Judgement rationale: *weldability*: CrMo grades need preheat and controlled cooling at the base and head welds. *availability / cost*: E355 honed tube is the stock cylinder tube; CrMo tube is a special order.

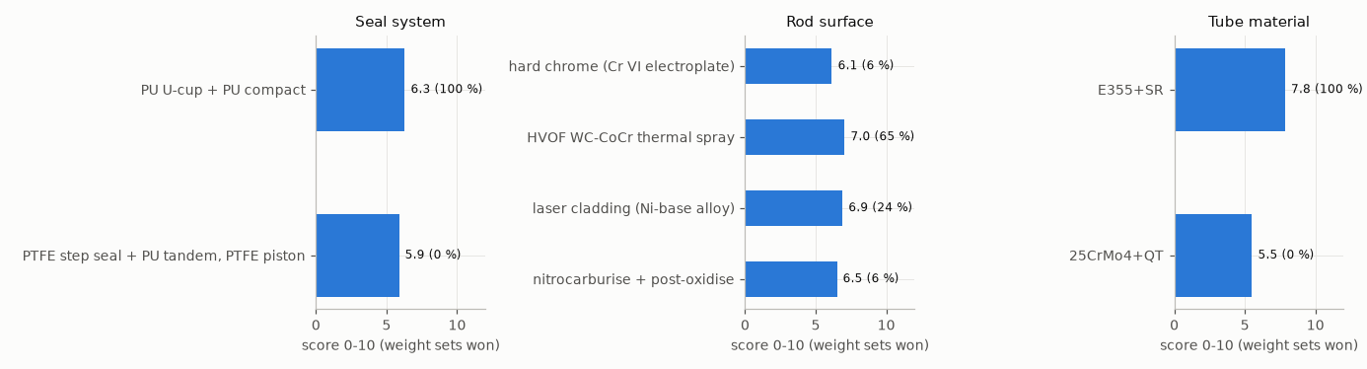
[picture p28: docs/img/LD-80_aoa.png]
AoA


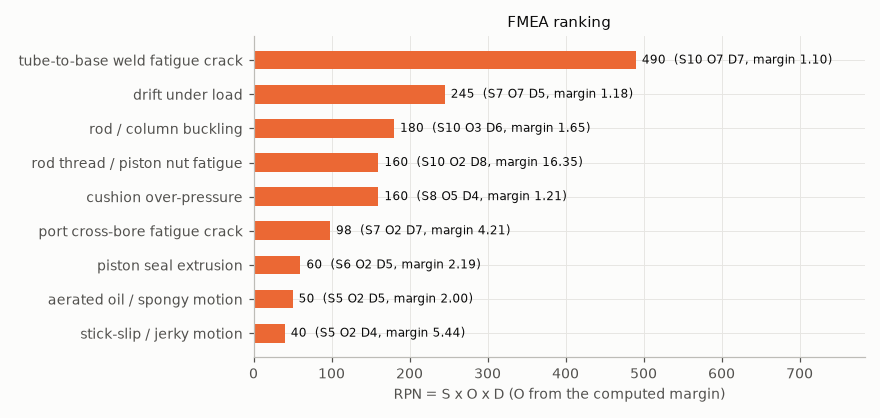
[picture p29: docs/img/LD-80_fmea.png]
FMEA


## Manufacturing hand-off (final revision) to the CNC part-family generator

Rows derived from the verified design (groove sizes illustrative, by size band):

```json
{
 "rod_end": {
  "id": "RE-LD-80-revC",
  "rod_d": 63.0,
  "thread_d": 48,
  "pitch": 2,
  "thread_len": 41,
  "relief_w": 5,
  "spigot_d": 51,
  "spigot_len": 38,
  "chamfer": 2,
  "material": "42CrMo4"
 },
 "piston": {
  "id": "PI-LD-80-revC",
  "bore_d": 80.0,
  "od_clear": 0.3,
  "inner_d": 51,
  "length": 50,
  "seal_w": 16.0,
  "seal_bottom_d": 62.0,
  "guide_w": 5.6,
  "guide_bottom_d": 75.0,
  "guide_inset": 4.0,
  "chamfer": 1,
  "stock_d": 85.0,
  "material": "C45"
 },
 "gland": {
  "id": "GL-LD-80-revC",
  "rod_d": 63.0,
  "id_clear": 0.2,
  "od": 79.95,
  "length": 70,
  "oring_w": 4.8,
  "oring_bottom_d": 72.95,
  "oring_z": 48,
  "wiper_w": 6.3,
  "wiper_bottom_d": 73.0,
  "wiper_z": 2,
  "seal_w": 8.1,
  "seal_bottom_d": 75.0,
  "seal_z": 18,
  "guide_w": 5.6,
  "guide_bottom_d": 68.0,
  "guide_z": 35,
  "chamfer": 1,
  "stock_d": 85.0,
  "material": "C45"
 }
}
```

Design-side checks: gland: 2.5 mm wall between the rod-seal groove and the OD (< 3 mm)

| part | 07 generate + verify | tool library | lines | cycle time s |
|---|---|---|---|---|
| RE-LD-80-revC | PASS | 07 base library | 78 | 184.9 |
| PI-LD-80-revC | PASS | 07 base library | 145 | 630.8 |
| GL-LD-80-revC | PASS | 07 base library | 173 | 1141.1 |
