chad416/hydraulic-cylinder-design-verification/docs/DOSSIER.md

# Hydraulic cylinder: from order specification to verified design to acceptance test

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

---

## 0. The question and the answer

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

1. **Fatigue at the tube-to-base weld.** The flat base stops the tube from expanding, which bends the wall next to it. At the original weld position, 10 mm from the base face, this raises the longitudinal stress to 2.2 × the membrane value (HD-160).
    - Rev A fatigue stress factor: **0.38** for the required 4 × 10^5 duty cycles.
    - Moving the girth weld to the point where the edge moment changes sign (βx = π/4, 19 mm from the base face) gives **1.09** with the same tube.
    - Thickening the tube instead works poorly. In a design-exploration run (not in the report), a 25 mm wall, 2.2 × thicker, still gave only 0.81 with the weld left at 10 mm.
2. **The cushion chamber is not protected by the port relief valve.** With an overrunning load and cold oil, the cap cushion reached **446 bar** against a 280 bar relief and a 420 bar proof pressure (HD-160 rev A).
    - That peak is also what drives the weld and port fatigue damage.
    - It is fixed at system level: an interface requirement limits the retract command to 0.55 because the load overruns on retraction, and the needle opens to 8 mm².
3. **Buckling of the long loader cylinder (LD-80).** The ordered 50 mm rod reaches first yield at **0.96 ×** the push at relief, once the rod tilt allowed by the bearing clearances, bow, pin eccentricity and self weight are included.
    - The rod-only Euler shortcut says 0.82×; the elastic stepped-column load says 1.28×.
    - A 56 mm rod cannot reach the 1.5× target at any stop-tube length: it peaks at 1.33 near 100 mm and falls again for longer tubes.
    - A 63 mm rod with a 50 mm stop tube reaches **1.65×**.
4. **One order requirement cannot be met as written.** Drift ≤ 5 mm in 10 min (HD-160): oil cooling of only 4.4 K in the locked cap chamber already uses the whole allowance. It goes back to the customer as a specification issue (Wasson Principle 19.4, p. 400: a specification must bound a *feasible* solution space).
5. **Seal friction is calibrated to published measurements**, not assumed (section 7). A first version of this dossier used assumed seal data and concluded that smooth motion at 10 mm/s was infeasible (stick-slip onset 12 mm/s). The measured data put the onset at 1.8 mm/s (PTFE system) and 2.3 mm/s (PU), so R-12 is met. That reversal is the reason to calibrate before concluding.

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

LD-80 rev C also takes the PTFE seal system that its own trade study picked in 100 % of weight sets.

The parts are handed to the CNC part-family generator (project 07), which generates and verifies the lathe programs. For LD-80 rev C, 07 accepts and verifies all three parts. For HD-160 rev B, it rejects the gland: its internal grooving tool reaches 6 mm and the wiper groove is 6.15 mm deep.

---

## 1. Need, problem space and concept of operations (Wasson ch. 4-6)

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

**Stakeholders and their needs** (Principle 4.12, p. 89, operational needs):

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

---

## 2. Phases, modes and states (Wasson ch. 7)

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

---

## 3. Requirements derived from the order and the standards (Wasson ch. 19-22)

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

- an order clause (force, speed, pressure, duty, drift, smooth speed);
- a standard's method (ISO 10100 acceptance modules, the ISO/TS 13725 approach to buckling, EN 1993-1-9 weld fatigue);
- a derived need found by analysis, for example "the cushion chamber is not protected by the relief, so its peak needs its own requirement".

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

| ID | Requirement (short) | Source | Method | HD-160 rev B | LD-80 rev C |
|---|---|---|---|---|---|
| R-01 | extend at ≥ 0.95 v_max against the load | order | A; T | met | met |
| R-02 | tube von Mises ≤ Re/2 at relief (Pm) | Lamé; design rule | A | met | met |
| R-03 | no yield at proof pressure | ISO 10100 §8.3 (factor assumed 1.5) | A; T | met | met |
| R-04 | base plate ≤ 1.5 Re/2 (Pb, conservative bound) | plate theory | A | met | met |
| R-05 | base junction ≤ 2 Re (PL+Pb+Q, shakedown) | ASME VIII-2 Part 5 categories | A | met | met |
| R-06 | rod thread ≤ Re/2 at relief pull | ISO 898-1 | A | met | met |
| R-07 | first yield at full extension ≥ 1.5 × push at relief | ISO/TS 13725 approach; 1.5 = project target | A | met (1.65) | met (1.65) |
| R-08 | every fatigue location survives the required duty cycles | order duty; S-N sources | A; T (ISO 10771-1) | met (1.09, weld) | met (1.15, weld) |
| R-09 | piston-seal extrusion gap ≤ allowable | seal makers' gap charts (values assumed, tables not retrieved) | A; I | met | met |
| R-10 | cushion peak ≤ proof pressure, 0-40 °C | derived (relief does not protect the cushion) | A; T | met (324 / 420 bar) | met (273 / 330 bar) |
| R-11 | end-stop impact ≤ 0.10 m/s | project target | A; T | met (0.080) | met (0.090) |
| R-12 | no stick-slip down to v_min | order; seal data from Sârbu et al. 2022/2024 | A; T (ISO 10100 module F) | met (onset 1.8 mm/s) | met (onset 1.8 mm/s) |
| R-13 | drift ≤ 5 mm / 10 min | order | A; T (ISO 10100 module P) | **not met** (4.4 K cooling uses it up) | met only below 5.9 K cooling |
| R-14 | lowest natural frequency reported | TPM (Section 21.8, p. 442) | A | 11.0 Hz | 11.1 Hz |

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

**Specification issues found** (Principle 19.4, p. 400, feasibility):

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

---

## 4. Architecture and interfaces (Wasson ch. 26-27)

**Physical architecture** (Principle 26.5, p. 551):

```
rear pin ─ base (welded) ─ tube ─ head/gland (bearing, rod seal, wiper) ─ rod ─ rod eye ─ front pin
                │                         │
            cap cushion             rod cushion spear
            port A (tube or block)  port B (tube or block)
          piston (guide rings, piston seal) on rod thread + nut
```

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

---

## 5. Budgets and margins (Wasson ch. 31)

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

---

## 6. Analysis of alternatives (Wasson ch. 32)

Method after Wasson Fig. 32.7 (p. 690):

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

| Trade | Result (HD-160 rev B) | Robust? | What decides it |
|---|---|---|---|
| Seal system | PTFE step seal + PU tandem, PTFE piston seal | HD-160: the PU system is **not viable** (extrusion margin 0.90 < 1, R-09), so it is screened out before scoring (Wasson's viable-alternative rule, p. 683). LD-80: PTFE wins 81 % of weight sets; no ±10 % weight change flips it | **model (measured-data seals):** stick-slip onset 1.8 vs 2.3 mm/s, so both are smooth at 10 mm/s; lower friction and a larger extrusion margin for PTFE. These outweigh the judgement criteria (dry rod, contamination, cost) that favour PU. |
| Rod surface | HVOF WC-CoCr (65 % of weight sets) ahead of laser cladding (24 %); hard chrome last (6 %) | no ±10 % flip, but **all scores are judgement**, so the ranking is only as good as the scores | the regulatory criterion: Cr(VI) restriction dossier submitted 11 Apr 2025, opinions pending (news source, section 13). Coupon tests (salt spray ISO 9227, abrasion) would replace the judgement scores. |
| Tube material | E355 +SR | wins 100 % of weight sets | **model:** the stronger 25CrMo4 tube is sized thinner (7.5 mm instead of 11.25 mm), so its *weld* fatigue factor drops from 1.09 to 0.53. Higher strength does not help a weld. |

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

---

## 7. Modelling and simulation (Wasson ch. 33)

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

| Model | Fidelity | Verified against (test in `tests/test_cylver.py`) | Not modelled |
|---|---|---|---|
| Lamé, plates | closed form, linear elastic | thin-wall limit; radial equilibrium | plasticity, autofrettage |
| base-junction edge bending | thin-shell beam-on-elastic-foundation | closed-form edge moment; zero at βx = π/4 | base rotation (real base is not rigid), weld geometry; rm/t 4-9 is near the theory's limit |
| buckling | Euler-Bernoulli FE, 160 elements, geometric stiffness, P-δ with imperfections | Euler for 4 end conditions (0.2 %); exact two-segment equation (0.2 %); secant formula and 1/(1-P/Pcr) amplification (1 %) | the ISO/TS 13725 equations themselves; shear; spherical-bearing friction; rod-in-tube contact beyond the two bearings |
| rainflow / Miner | ASTM E1049 three-point | the standard's worked example, exact counts | sequence effects; mean stress for welds (deliberately ignored, as in EN 1993-1-9) |
| dynamic model | lumped: 2 chambers + 2 lines + valve lag, orifice edges, cushions, Stribeck friction, stiff stops | natural frequency = oil-column formula (2 %); loop-gain limit converges to Merritt's K_v < 2ζω_h as the valve gets fast (to 0.90-0.95 ×, the remainder from the asymmetric areas); cushion monotonic in needle size | line dynamics (waves), pump flow limit, valve spool forces, temperature rise, cavitation details, dissolved-air release |
| bulk modulus | Merritt series form, free air by gas law | liquid limit; air softens at low pressure | air dissolving at high pressure (Gholizadeh et al. 2011): conservative |
| seal friction | Stribeck per seal element (Coulomb level growing with pressure, static excess, Stribeck speed, viscous); tandem rod seal = two elements | **calibrated** to Sârbu et al. (Polymers 2024, Tables 3 and 5; 60 mm PTFE and PU coaxial seals, 0-160 bar). Predicted stick-slip onset 0.52 mm/s (PTFE) and 2.3 mm/s (PU) against the measured 0.2-0.3 and 1.4 mm/s (Polymers 2022): conservative by about 2 ×, consistent with the damping the model leaves out | the viscous coefficient (assumed; matters only at speed); PU coaxial data used for a PU U-cup; batch scatter |
| stick-slip | 1-DOF, constant-flow drive, Stribeck | linear criterion dF/dv < 0 agrees with the simulation (stick-slip at 0.5 × onset, smooth at 2 × onset) | frictional memory and lag |

**Two model-based findings that only the simulation could give:**

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

---

## 8. Reliability and FMEA (Wasson ch. 34)

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

| Failure mode | Margin | O | RPN |
|---|---|---|---|
| tube-to-base weld fatigue | 0.38 | 9 | 630 |
| port cross-bore fatigue (ports in the tube wall) | 0.33 | 9 | 441 |
| drift under load | 0.89 | 9 | 315 |
| cushion over-pressure | 0.94 | 9 | 288 |
| column buckling | 1.65 | 3 | 180 |
| piston-nut thread fatigue | 6.5 | 2 | 160 |
| piston-seal extrusion | 1.41 | 5 | 150 |

For rev B, the occurrence drops for three rows. The weld goes from O = 9 to 7 (margin 1.09), the port from 9 to 2 (margin 3.25) and the cushion from 9 to 5 (margin 1.30). The top of the rev B ranking is:

| Failure mode | Margin | O | RPN |
|---|---|---|---|
| base weld fatigue | 1.09 | 7 | 490 |
| drift | 0.89 | 9 | 315 |
| buckling | 1.65 | 3 | 180 |
| cushion over-pressure | 1.30 | 5 | 160 |

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

Other reliability points:

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

---

## 9. Verification and validation (Wasson ch. 13 and 28)

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

---

## 10. Manufacturing hand-off (the CNC part-family generator)

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

| Part | HD-160 rev B | LD-80 rev C |
|---|---|---|
| rod end | PASS | PASS |
| piston | PASS | PASS |
| gland | rejected: wiper groove 6.15 mm > 6 mm internal-grooving tool limit | PASS |

The rejection is useful feedback. Either a deeper internal grooving bar goes into the tool library, or the large-rod gland gets a different seal cross-section.

---

## 11. Results summary

| | HD-160 rev A (as ordered) | HD-160 rev B | LD-80 rev A (as ordered) | LD-80 rev B | LD-80 rev C |
|---|---|---|---|---|---|
| tube OD / rod (mm) | 182.5 / 100 | 182.5 / 100 | 90 / 50 | 90 / 63 | 90 / 63 |
| buckling (first yield / push at relief) | 1.65 | 1.65 | **0.96** | 1.65 | 1.65 |
| governing fatigue stress factor | **0.33** (port in tube) | 1.09 (weld) | **0.35** (port in tube) | **0.39** (port in tube) | 1.15 (weld) |
| cushion peak (bar), 0-40 °C | **446** | 324 | **463** | **411** | 273 |
| requirements not met | R-08, R-10, R-13 | R-13 | R-07, R-08, R-10 | R-08, R-10, R-11 | none |
| CNC hand-off (project 07) | - | gland rejected (tool depth) | - | - | 3 / 3 PASS |

---

## 12. Limits and assumptions (what is assumed vs sourced)

- **Not validated on hardware.** Every result is analysis and simulation. The acceptance procedure is the plan to validate the models.
- **Seal friction is calibrated to one published test series** (two 60 mm coaxial seals, PTFE and PU, 0-160 bar, Sârbu et al. 2022/2024). The viscous coefficients are still assumed, and the PU U-cup uses PU coaxial-seal data. **The extrusion-gap limits are still assumed:** the seal makers' tables could not be retrieved. Module F on the real cylinder would replace all of these.
- **ISO/TS 13725 equations were not available.** The buckling model follows the standard's published principles (geometric model, off-axis load, own weight, fully extended) with a classical beam-column FE. The first-yield criterion and the 1.5 target are this project's choices.
- **Material values are from memory or secondary summaries** (marked `checked: false` in `data/materials.json`). E355 +SR uses 450 / 580 MPa from a mill catalogue summary; a recalled 520 / 640 was not confirmed and is not used.
- **The edge-bending solution assumes a rigid base** and thin-shell theory. At rm/t = 4-9 that is at the edge of its validity. A real base rotates a little, which lowers the bending. The zero-moment weld position should be confirmed by an axisymmetric FE model or strain gauges on the type-test unit.
- **The port Kt of 3** is a typical cross-bore value (assumed). Ports in end blocks are modelled as Kt × pressure. Peaks above Rm with the elastic Kt are reported as static failures, not given a fatigue life.
- **The duty cycle is a design duty cycle** (extend with a mid-stroke stop, hold, retract, hold) invented for the example. The real spectrum must come from the customer or from measurement.
- **The pump is an ideal pressure source.** Line wave dynamics are not modelled, and air is treated as free (conservative at high pressure).
- **Proof pressure factor 1.5** is assumed until checked in ISO 10100 (a vendor guide, S25, gives the same typical value; the ISO text is paid and was not available).
- **The groove sizes in the CNC rows are illustrative**, not seal-catalogue values.

---

## 13. References and how far each was checked

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

| # | Source | Used for | Status |
|---|---|---|---|
| W | C. S. Wasson, *System Engineering Analysis, Design, and Development*, 2nd ed., Wiley 2016 | dossier structure; the principles cited per section (book page numbers) | checked: chapters 4-7, 13, 19-22, 26-28, 31-34 extracted and the cited principles read |
| S1 | ISO 10100:2020 *Hydraulic fluid power - Cylinders - Acceptance tests* | ATP structure: modules L (8.2, 8.3), P (9), F (10.4.1, 10.4.2, 10.6.2) | table of contents checked (DIN preview); test pressures and durations NOT available |
| S2 | ISO 10771-1:2015 *Fatigue pressure testing of metal pressure-containing envelopes* | type test Q-1 | scope checked via store pages: test pressure set by the user, ISO/TR 10771-2 rating method, Annex B = cylinders; full text not available |
| S3 | ISO/TS 13725:2021 *Method for evaluating the buckling load of a hydraulic cylinder* | buckling principles | scope checked via store pages: geometric model, off-axis load, own weight, fully extended; based on Hoblit and NFPA T3.6.37; not for internal rod buckling; spherical-bearing friction not included. The equations of the standard were NOT available and are not reproduced |
| S4 | H. Gholizadeh, R. Burton, G. Schoenau, "Fluid bulk modulus: a literature survey", Int. J. Fluid Power 12(3), 2011, pp. 5-15 | effective bulk modulus, entrained vs dissolved air, critical pressure | checked (paper read) |
| S5 | H. E. Merritt, *Hydraulic Control Systems*, Wiley 1967 | chamber continuity, hydraulic natural frequency, K_v < 2 zeta omega_h | not re-checked; natural frequency and gain rule reproduced by tests against the model's own eigenvalues |
| S6 | M. Jelali, A. Kroll, *Hydraulic Servo-systems*, Springer 2003 | valve-cylinder modelling | not re-checked |
| S7 | R. G. Budynas, J. K. Nisbett, *Shigley's Mechanical Engineering Design*, "pressurized cylinders" | Lame | not re-checked; test: thin-wall limit and radial equilibrium |
| S8 | S. Timoshenko, S. Woinowsky-Krieger, *Theory of Plates and Shells*, 2nd ed. | circular plate; cylinder edge bending (beam on elastic foundation) | not re-checked; test: edge moment closed form and zero-moment point |
| S9 | S. Timoshenko, J. Gere, *Theory of Elastic Stability* | stepped bars, secant formula, amplification 1/(1-P/Pcr) | not re-checked; tests: FE vs Euler (4 end conditions), vs the exact two-segment equation, vs secant formula and amplification |
| S10 | ASTM E1049-85 *Standard Practices for Cycle Counting in Fatigue Analysis* | rainflow | not re-checked; test: the standard's worked example (counts 3:0.5, 4:1.5, 6:0.5, 8:1, 9:0.5) |
| S11 | EN 1993-1-9 *Fatigue* | weld S-N shape, gamma_Mf | not re-checked |
| S12 | IIW recommendations (Hobbacher, 2nd ed. 2016) | FAT 71 / 36 for one-sided butt welds with / without root inspection | not re-checked |
| S13 | FKM guideline *Analytical strength assessment* | machined steel endurance order of magnitude | not re-checked |
| S14 | VDI 2230 Part 1 (2015) | thread endurance sigma_ASV, load factor phi_n | not re-checked |
| S15 | ISO 898-1 | thread stress area | test against the tabulated M20 value (245 mm^2) |
| S16 | B. Armstrong-Helouvry, P. Dupont, C. Canudas de Wit, "A survey of models, analysis tools and compensation methods for the control of machines with friction", Automatica 30(7), 1994 | Stribeck model, stick-slip | not re-checked; test: simulation agrees with the linear criterion |
| S17 | H. K. Mueller, B. S. Nau, *Fluid Sealing Technology* | pressure-dependent seal friction, extrusion | not re-checked |
| S23 | F. A. Sârbu, F. Arnăuţ, A. Deaconescu, T. Deaconescu, "Theoretical and experimental research concerning the friction forces developed in hydraulic cylinder coaxial sealing systems made from polymers", *Polymers* 16(1):157, 2024, doi:10.3390/polym16010157 (CC BY) | seal friction vs pressure and speed (Tables 3, 5) | checked: full text read, tables used |
| S24 | same group, "Experimental research on polymer-based coaxial sealing systems of hydraulic cylinders for small displacement velocities", *Polymers* 14(2):290, 2022, doi:10.3390/polym14020290 (CC BY) | seal size (60 × 4 mm); measured stick-slip onsets (PTFE < 0.2 mm/s, PU < 1.4 mm/s) | checked: full text read |
| S25 | hydraulic-cylinders.net, "Hydraulic cylinder pressure testing: ISO standards and quality control procedures" (vendor guide) | proof pressure "typically 1.5 × the maximum working pressure" | secondary, vendor source; ISO 10100 §8.3 itself not available |
| S18 | EN 10305-1 (E355 +SR tube), EN 10083-2/-3 (C45, 42CrMo4, 25CrMo4) | material values | not re-checked; E355 +SR 450/580 MPa from a mill catalogue seen as a search summary (my recalled 520/640 was NOT confirmed and is not used) |
| S19 | ECHA Cr(VI) restriction process: Annex XV dossier 11 Apr 2025; consultation 18 Jun - 18 Dec 2025; RAC/SEAC opinions pending (Freyr regulatory news, 25 May 2026) | coating trade, regulatory criterion | checked via search summary of the news item; final adoption date unknown |
| S20 | ASME BPVC Section VIII Division 2, Part 5 (design by analysis) | stress categories Pm / Pb / PL+Pb+Q and the 2 Re shakedown limit | not re-checked |
| S21 | ASTM D341 | viscosity-temperature (Walther) | not re-checked; test: VG 46 = 46 cSt at 40 C by construction |
| S22 | ISO 3320 | preferred bores and rods | not re-checked (values only used as a list) |
