chad416/hydraulic-cylinder-design-verification/(commit log)

2026-11-09 cylver 0.1.0: hydraulic cylinder from order spec to verified design to acceptance test
    - Systems-engineering dossier along Wasson (2nd ed.) ch. 4-7, 13, 19-22, 26-28, 31-34 (docs/DOSSIER.md + PDF)
    - Sizing, Lame / plate / base-junction edge bending, stepped beam-column buckling FE with clearance tilt
    - Valve-cylinder dynamic model (bulk modulus with air, cushions, Stribeck friction) -> duty pressure history
    - Rainflow + EN 1993-1-9 / FKM / VDI 2230 fatigue, equal-damage ISO 10771-1 type-test pressure
    - Requirements, FMEA with occurrence from computed margins, ISO 10100-structured acceptance limits, AoA with sensitivity
    - CNC hand-off to the part-family generator (imported, unchanged)
    - Two i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
2026-11-09 Seal friction calibrated to published measurements; F-2 judged on the fitted onset
    - seals.py: Stribeck elements calibrated to Sarbu et al., Polymers 16(1):157 (2024) and 14(2):290 (2022);
    predicted stick-slip onsets conservative within about 2x of the measured ones (new test)
    - R-12 is now met for every design (onset 1.8 mm/s PTFE system, 2.3 mm/s PU); LD-80 rev C meets all requirements
    - AoA screens non-viable alternatives before ranking (HD-160 PU seals fail R-09)
    - acceptance F-2: stick-slip onset of the fitted bench curve <= required smooth speed
    - dossier, README and reports regenerated; 26 tests
2026-11-09 Axisymmetric FE check of the base weld, heavier grooving bar for large glands, dossier at top level
    - axisym.py: Q4 axisymmetric FE of tube + base; confirms the shell edge solution (zero-moment point
    18.9 vs 19.0 mm, edge bending within 1.5 %); the weld fatigue check now uses the FE structural stress
    (HD-160 rev B 1.03, LD-80 rev C 1.10)
    - CNC hand-off: a heavy internal grooving bar from data/cnc_tooling.json for glands deeper than the
    base library's 6 mm; all six parts of both final designs pass project 07
    - R-15 mounting interface (ISO 6022 / ISO 6020-2), status open: tables in the paid standard
    - DOSSIER.md and DOSSIER.pdf at the repository root, with a decision log; OPEN_ITEMS.md
    -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
2026-11-10 Seal extrusion limits from the seal maker's installation tables; seal trade re-run (decision D-15)
    Closes open item O-5: the allowable radial extrusion gaps are now the published
    installation tables (Glyd Ring, U-Cup PUA, Stepseal 2K) instead of assumed values.
    With them the polyurethane seal set becomes viable for both orders and the
    judgement-weighted trade ranks it first, while every model criterion still favours
    PTFE; the choice is recorded as decision D-15 and handed on as O-12.
